Open-Source-Community-for-AR/Headset-v1.0/README.md

# OpenAR Headset v1.0
Files for 3d printing the Open AR headset and the assembly instructions.
