Open-Source-Community-for-AR/Headset-v1.0/STL files/Middle-adjusting-piece.stl

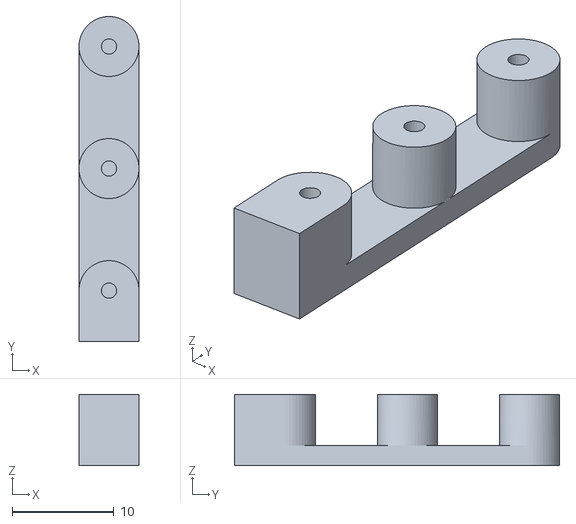
[picture p1: CAD file, 2022-04-14]
STL files/Middle-adjusting-piece.stl
5.90 x 31.9 x 7.00
