Open-Source-Community-for-AR/Headset-v1.0/STL files/Mirror-adjustment-piece.stl

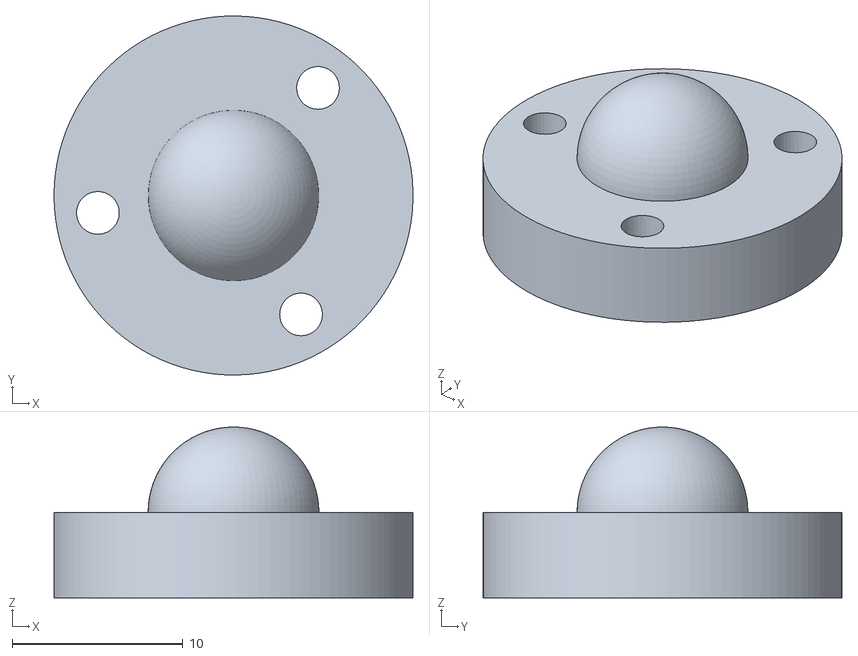
[picture p2: CAD file, 2022-04-14]
STL files/Mirror-adjustment-piece.stl
21.0 x 21.0 x 10.0
