Open-Source-Community-for-AR/Headset-v1.0/STL files/Middle-adjusting-piece-cover.stl

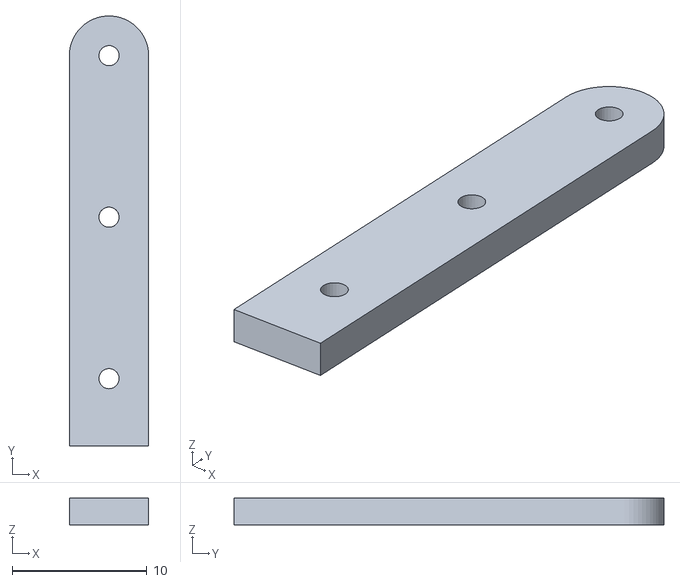
[picture p3: CAD file, 2022-04-14]
STL files/Middle-adjusting-piece-cover.stl
5.90 x 31.9 x 2.00
