Open-Source-Community-for-AR/Headset-v1.0/STL files/Body-optics-side-cover.stl

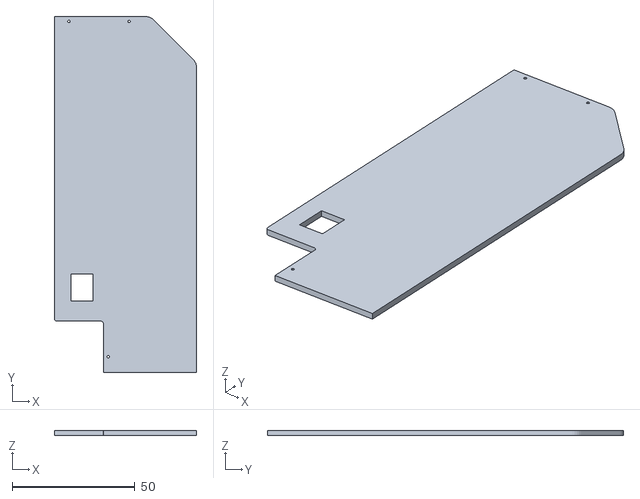
[picture p4: CAD file, 2022-04-14]
STL files/Body-optics-side-cover.stl
58.0 x 144.9 x 2.00
