Open-Source-Community-for-AR/Headset-v1.0/STL files/Support-body.stl

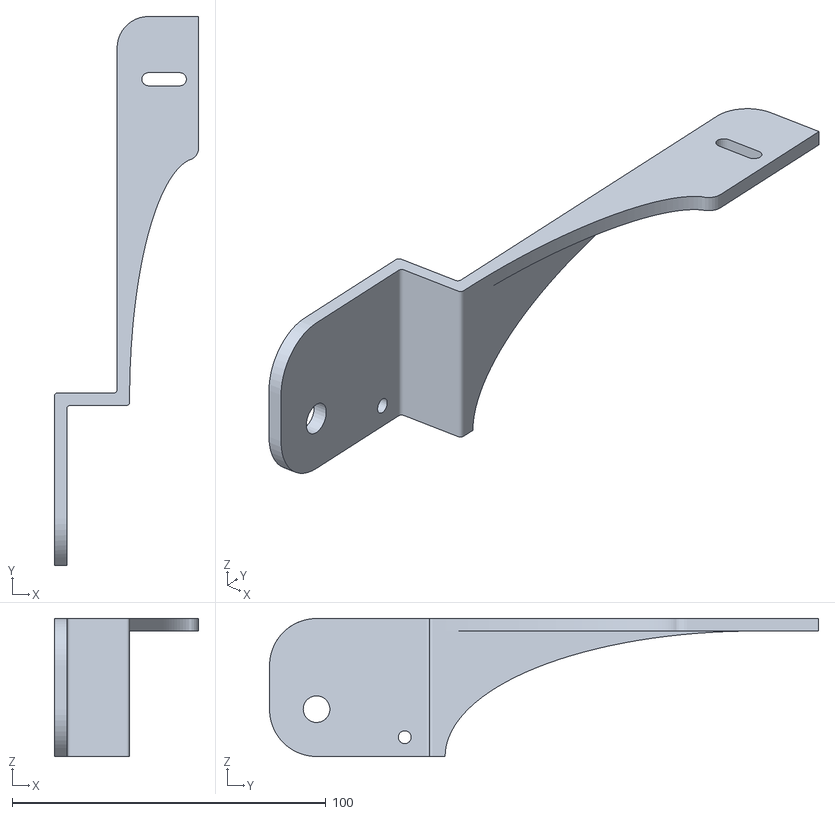
[picture p5: CAD file, 2022-04-14]
STL files/Support-body.stl
46.0 x 175.0 x 44.0
