Open-Source-Community-for-AR/Headset-v1.0/STL files/Middle-body.stl

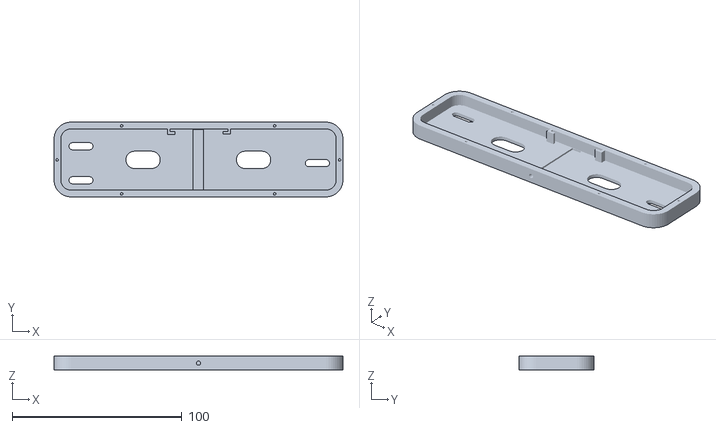
[picture p6: CAD file, 2022-04-14]
STL files/Middle-body.stl
170.0 x 44.0 x 8.30
