Open-Source-Community-for-AR/Headset-v1.0/STL files/Spring.stl

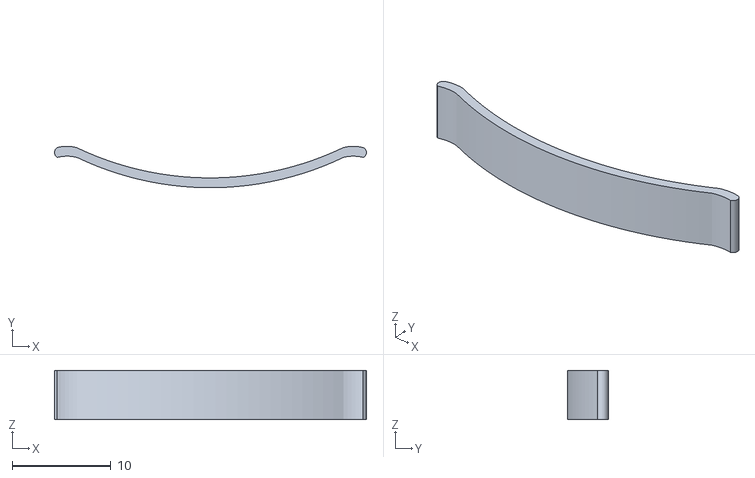
[picture p7: CAD file, 2022-04-14]
STL files/Spring.stl
31.6 x 4.18 x 5.00
