Open-Source-Community-for-AR/Headset-v1.0/STL files/Plate-holder.stl

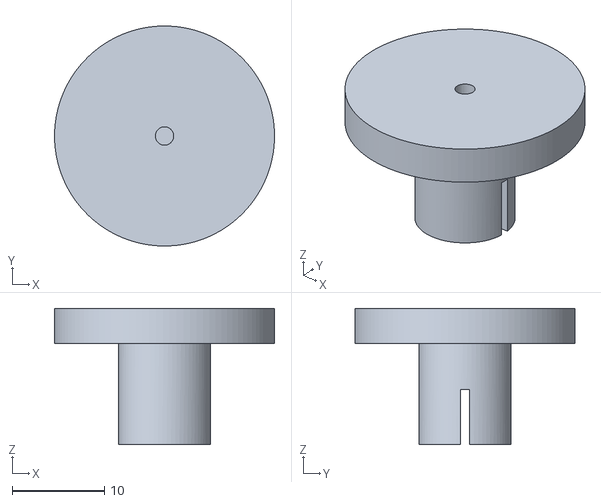
[picture p8: CAD file, 2022-04-14]
STL files/Plate-holder.stl
23.9 x 23.9 x 14.8
