Open-Source-Community-for-AR/Headset-v1.0/STL files/Lens-holder.stl

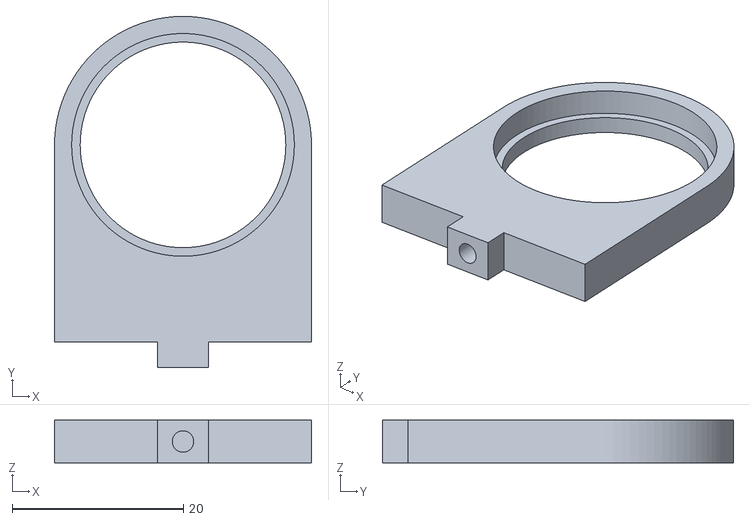
[picture p9: CAD file, 2022-04-14]
STL files/Lens-holder.stl
30.0 x 41.0 x 5.00
