Open-Source-Community-for-AR/Headset-v1.0/STL files/Body-optics-side.stl

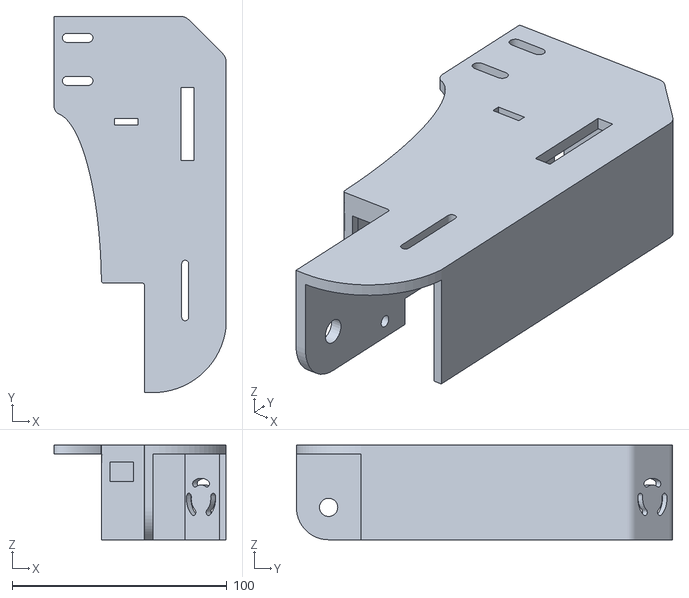
[picture p10: CAD file, 2022-04-14]
STL files/Body-optics-side.stl
80.0 x 175.0 x 44.0
