Open-Source-Community-for-AR/Headset-v1.0/STL files/Middle-body-cover.stl

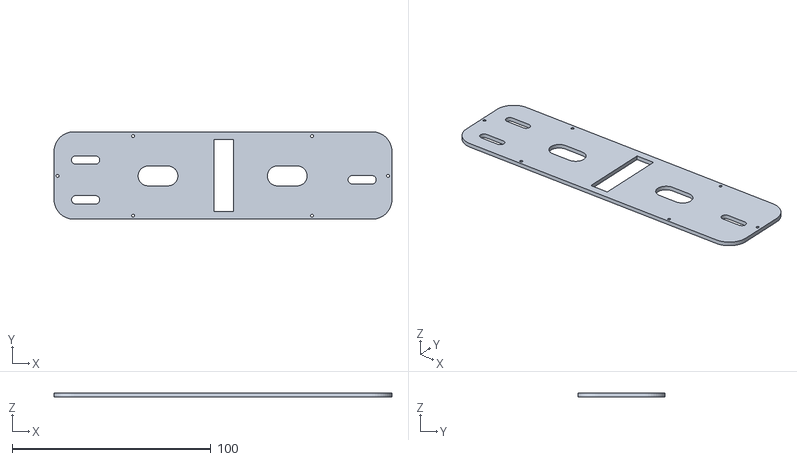
[picture p11: CAD file, 2022-04-14]
STL files/Middle-body-cover.stl
170.0 x 44.0 x 2.00
