Open-Source-Community-for-AR/Headset-v1.0/STL files/OLED-holder.stl

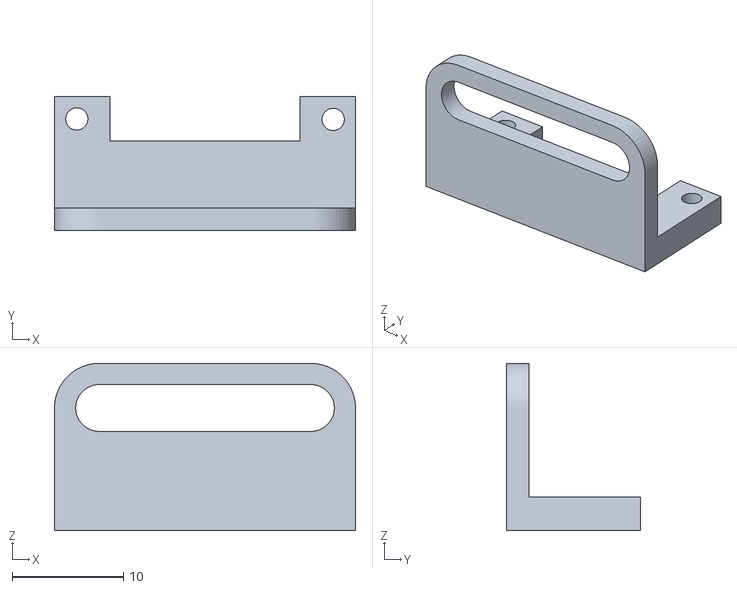
[picture p12: CAD file, 2022-04-14]
STL files/OLED-holder.stl
27.0 x 12.0 x 15.0
