Open-Source-Community-for-AR/Headset-v1.0/STL files/Rotating-eyepiece.stl

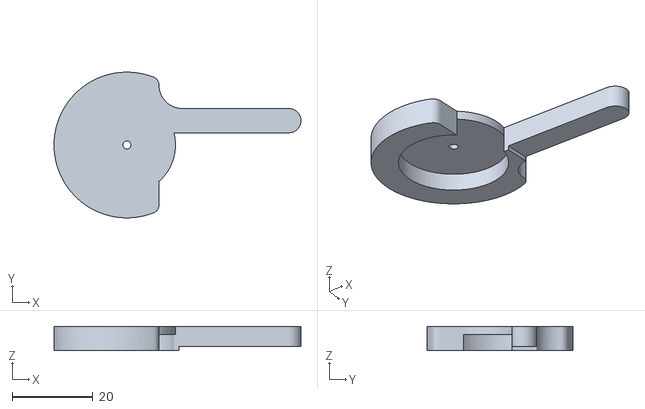
[picture p13: CAD file, 2022-04-14]
STL files/Rotating-eyepiece.stl
61.0 x 36.0 x 6.00
