Open-Source-Community-for-AR/Headset-v1.0/Assembly-instructions.pdf

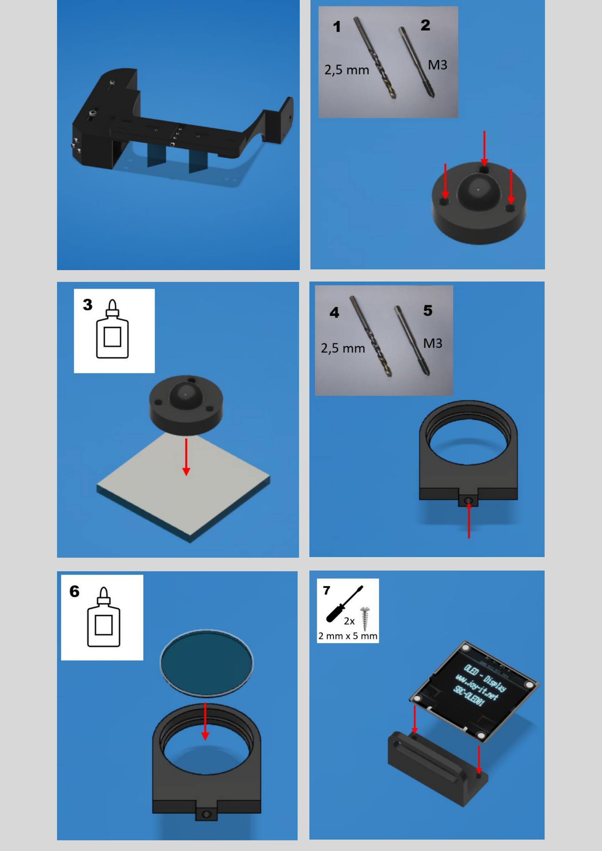
[picture p21: page 1]
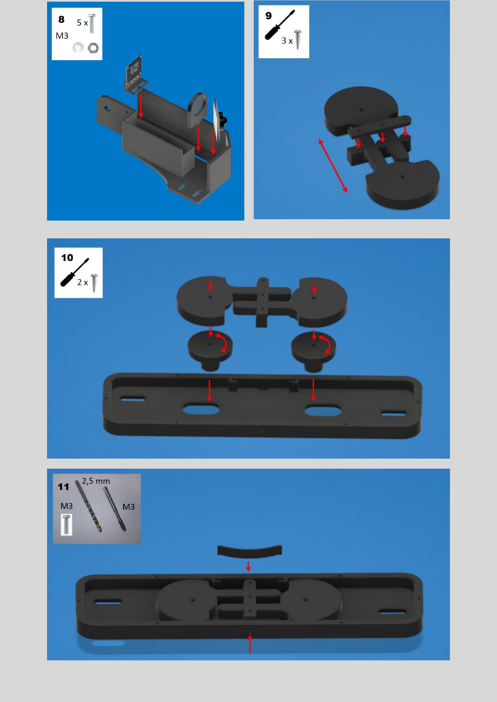
[picture p22: page 2]
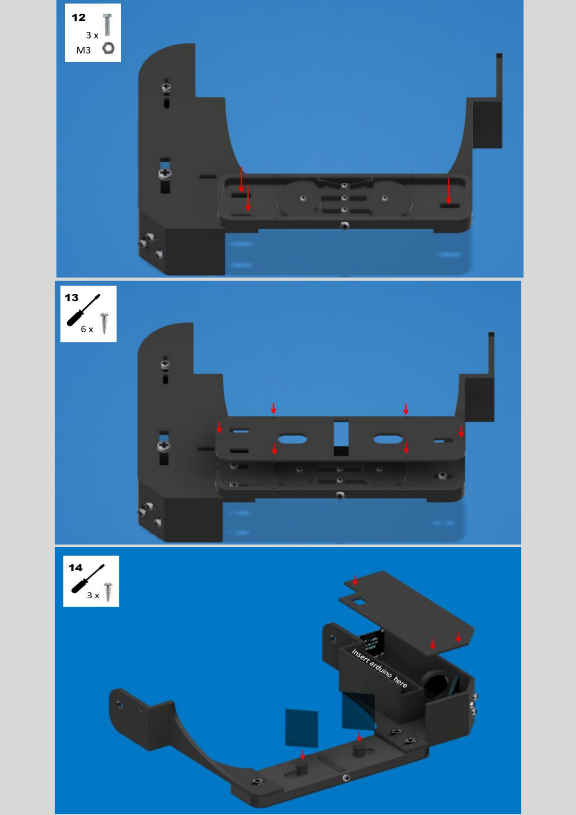
[picture p23: page 3]
